MehdiBerr/AfficheurPhotovoltaique/Images/Accueil_debar.PNG

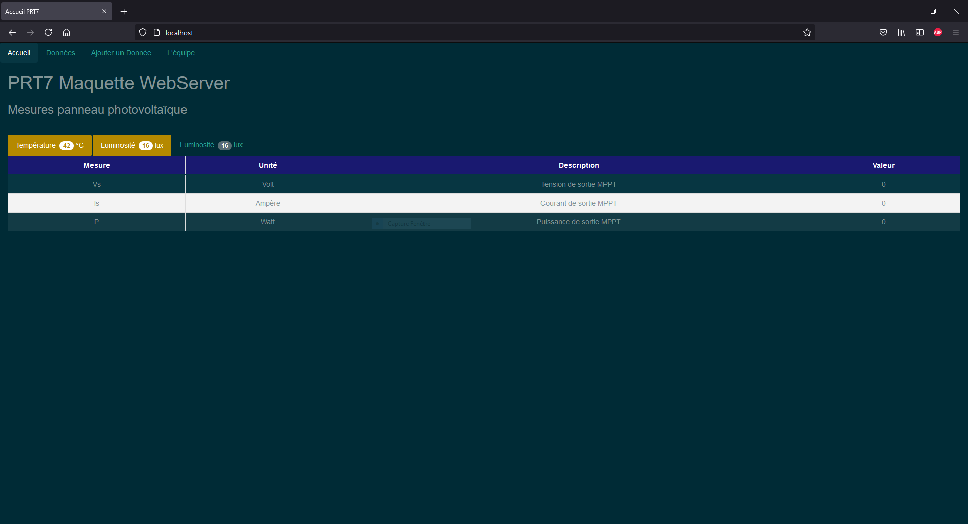
Images/Accueil_debar.PNG
