MehdiBerr/AfficheurPhotovoltaique/Images/Donnees_debar.PNG

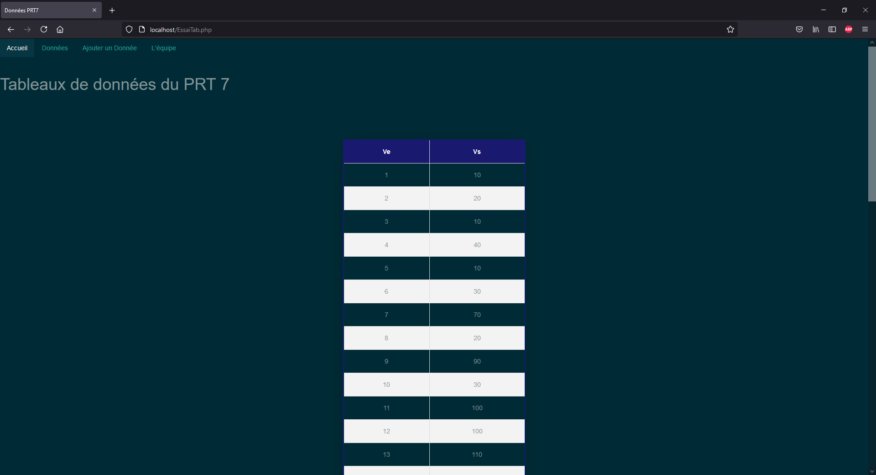
Images/Donnees_debar.PNG
