MehdiBerr/AfficheurPhotovoltaique/Images/Equipe_debar.PNG

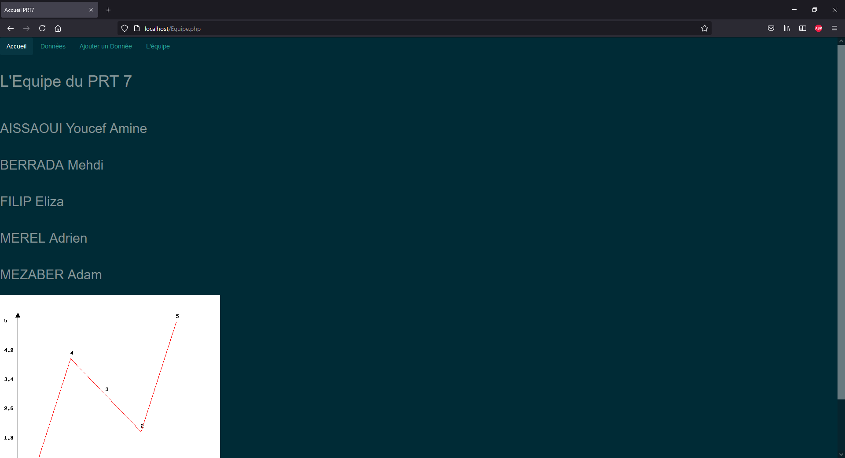
Images/Equipe_debar.PNG
