MehdiBerr/AfficheurPhotovoltaique/Images/Saisie_debar.PNG

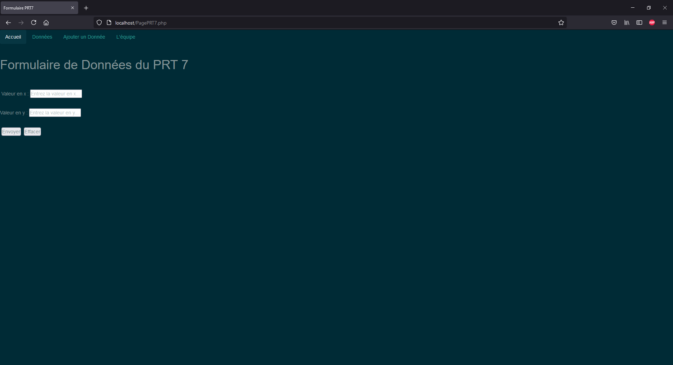
Images/Saisie_debar.PNG
