MehdiBerr/AfficheurPhotovoltaique/Site_Debarque/img.png

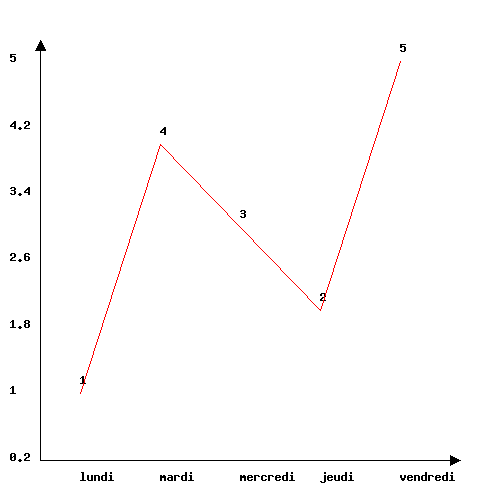
Site_Debarque/img.png
