MehdiBerr/AfficheurPhotovoltaique/Images/Circuit_cms_et_assemble.JPG

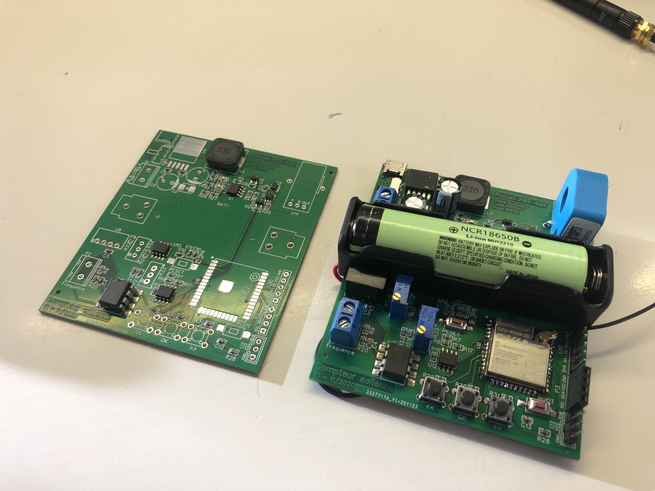
Images/Circuit_cms_et_assemble.JPG
