MehdiBerr/AfficheurPhotovoltaique/(commit log)

2020-10-11 Mise à jour Readme
    Ajout de la description et du cahier des charges
2020-10-12 Update README.md
    edit des valeurs de puissances / tensions / courants
2021-02-09 Update README.md
    Ajout de l'avertissement de ne pas connecter le VCC lors du téléversement
2021-02-09 Update README.md
    Ajout de l'amélioration indiquant d'éliminer le support de batterie
2021-02-09 Update README.md
    Ajout du problème de taille de support batterie
2021-03-29 Update README.md
    Choix de la lampe
2021-05-27 Recherche flash de la carte
